tutertlob/rny-1/(threads)

Thread 1 (2017-07-09):

機能要件確定

nobrooklyn, 2017-07-09:
機能要件を確定する。

nobrooklyn, 2017-07-16:
- ポストに郵便物が投函されたことを検知できる。
- ポストに投函された郵便物を確認できる。
- ポストから郵便物が取り出されたことを検知できる。
- 長期間ポストに郵便物が滞留していることを検知できる。
- 郵便物にはハガキや封書以外に、メール便やチラシも含まれる。
- 取出し側から取り出した郵便物を再度中に戻すことがある。
- 取出し口を開けて中身を確認しただけで取り出さないことがある。
ひとまずこんなところです。

Thread 2 (2017-07-09):

非機能要件確定

nobrooklyn, 2017-07-09:
非機能要件を確定する。
- デバイス
- フロントエンド
- サーバサイド

nobrooklyn, 2017-07-16:
- 機器の発熱や漏電による郵便物への影響（発火、溶解等）があってはならない。
- システム全体においてマルウェア感染を抑止する。
- 利用者に関するすべての情報は利用者以外に公開されてはならない。
- 万が一、利用者以外に情報が参照された場合に備え、暗号化等の、容易に参照できない措置を講じる。

Thread 3 (2017-07-09):

デバイスHW構成確定

nobrooklyn, 2017-07-09:
デバイスのHW構成を確定する。

Reiji-Nishiyama, 2017-07-15:
確定。パーツ選定と調達も完了。
[HW構成](https://drive.google.com/drive/folders/0BysYgGElEwkqUHBmZzZsNURuVTA?usp=sharing)
[パーツリスト](https://docs.google.com/spreadsheets/d/1ASKe4Y24WkBbAil3ncN_udZZaydx2GNa1yCTuJ-e_gA/edit?usp=sharing)

Reiji-Nishiyama, 2017-07-26:
This commit fixes #3

Reiji-Nishiyama, 2018-03-29:
HW構成は一旦[これで](https://github.com/tutertlob/rny-1/tree/master/Mailbox_sender)Fix。

Closed 2018-03-29.

Thread 7 (2017-07-20):

デバイスtoGWのプロトコル設計

nobrooklyn, 2017-07-20:
デバイスからGWに飛ばすメッセージプロトコルの設計。
既成の6LowPANを使うか、独自実装とするか。
画像データを扱うため、分割再結合などの考慮が必要。

Reiji-Nishiyama, 2018-03-29:
特定小電力無線モジュールIM920を使ったメッセージプロトコル設計済み。
詳細は[こちら](https://github.com/tutertlob/im920-arduino)。
ArduinoとJava用ライブラリを作成。
* Arduino用は[こちら](https://github.com/tutertlob/im920-arduino)
* Java用は[こちら](https://github.com/tutertlob/im920-java)

Closed 2018-03-29.

Thread 8 (2017-07-26):

バッテリーでHWを駆動させる

Reiji-Nishiyama, 2017-07-26:
起動時に電流が百数十mA以上流れることもありコイン電池でのArduino＋カメラのHWシステムが駆動ができない。カメラの消費電流80mA以上消費。

Reiji-Nishiyama, 2017-07-26:
モバイルバッテリーの使用を検討してみる。

Reiji-Nishiyama, 2018-03-29:
USBモバイルバッテリーで駆動可能。ただモノによってはArduinoと接続しても電力供給を開始してくれないものがあり使えない。
比較的安全なリチウムポリマー電池の使用も試してみる。
カメラの待機電力は半導体リレーやフォトリレーなどでカメラの電源ON/OFFしないと電池が保たない。

Closed 2018-05-10.

Thread 13 (2018-05-10):

電波が届かない

Reiji-Nishiyama, 2018-05-10:
建物の中と外との間での無線通信ができない。距離が短い

Reiji-Nishiyama, 2018-05-10:
無線の専門家コメント
・マンションは鉄筋と分厚いコンクリートに覆われていてシールドされているような状態なので、特小無線の通信環境としては厳しい。
・アンテナは外に出した方が良い。送受信側両方、それが難しい場合は送信側だけでも出せると少しは改善する。

Reiji-Nishiyama, 2018-05-10:
無給電中継というものがある模様。こちらの記事。なにか解決策にならないだろうか。
`http://mijikana.info/guidance/denki_71.htm`
それとこちら。
`http://mijikana.info/guidance/denki_32.htm`

う〜ん、何をどうすればいいのか。。。

Thread 14 (2018-05-10):

カメラのピンボケ

Reiji-Nishiyama, 2018-05-10:
カメラに近いところを撮影するとピンボケする。

Reiji-Nishiyama, 2018-05-10:
他メーカーの似たようなカメラモジュールは、レンズモジュールがスクリュー式の交換タイプになっている。また、同じレンズでもねじ込む量を変えるとピント位置を調整できる模様。
使用中のカメラも似たような構造で、レンズモジュールを取り外せることを確認。ピンと位置を調整できるかもしれない。

Reiji-Nishiyama, 2018-05-29:
レンズがスクリュー式でピント調整可能なことが判明。

Closed 2018-05-29.
