tutertlob/rny-1/(commit log)

2018-03-11 Store image records with the transceiver id to distinguish which cameras take.
2018-03-16 Append another reed switch
2018-03-16 Append the layout image of this arduino project.
